Sama289/ALU_and_Custumized_Counter/Phase_2.PDF

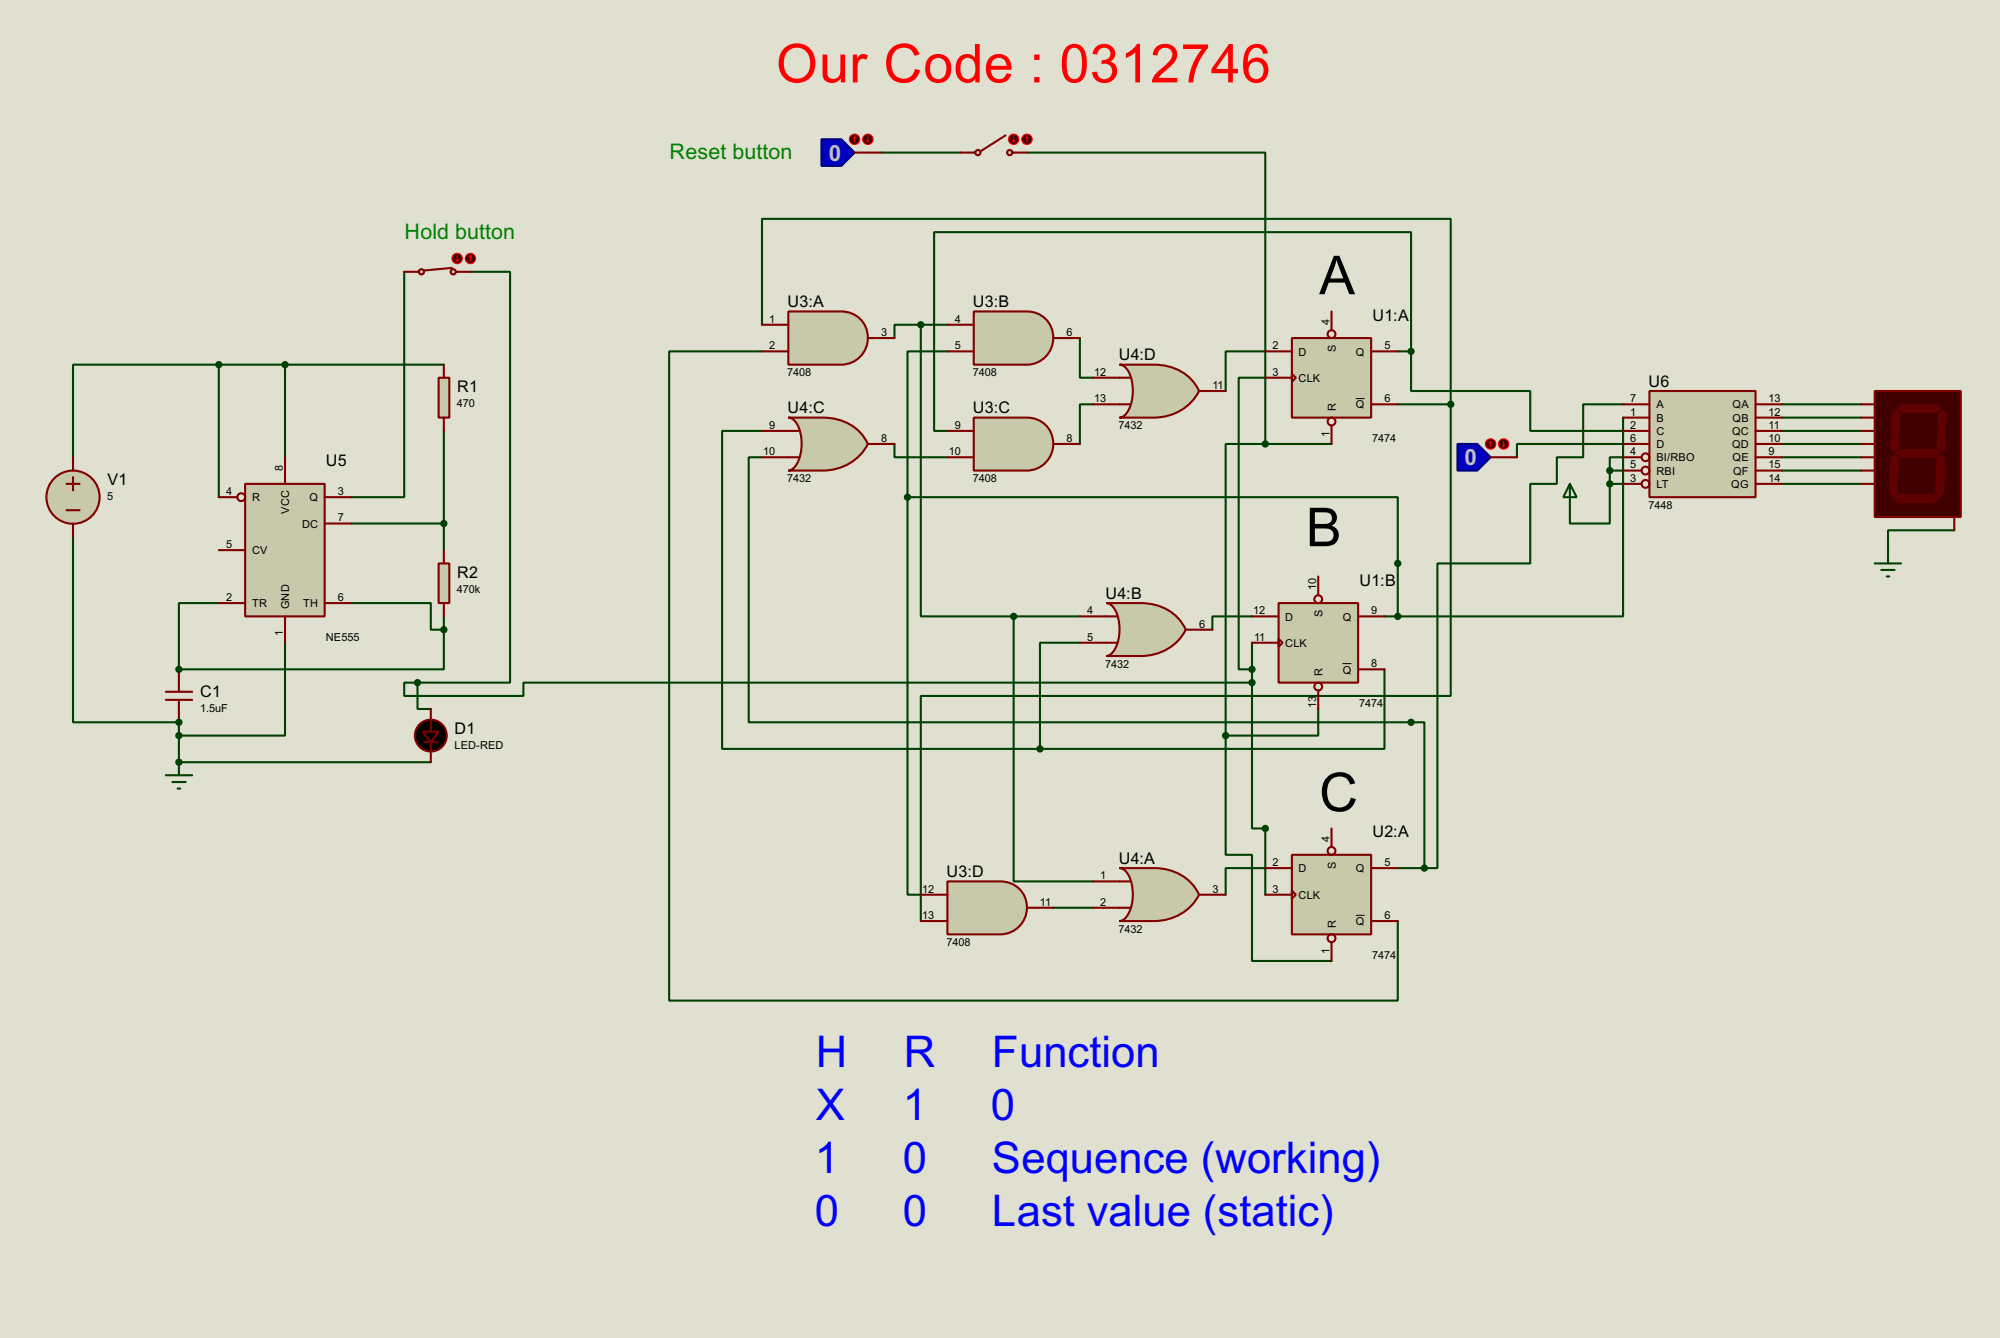
[picture p40: page 1]
