Sama289/ALU_and_Custumized_Counter/Phase 1 Simulation Final version.PDF

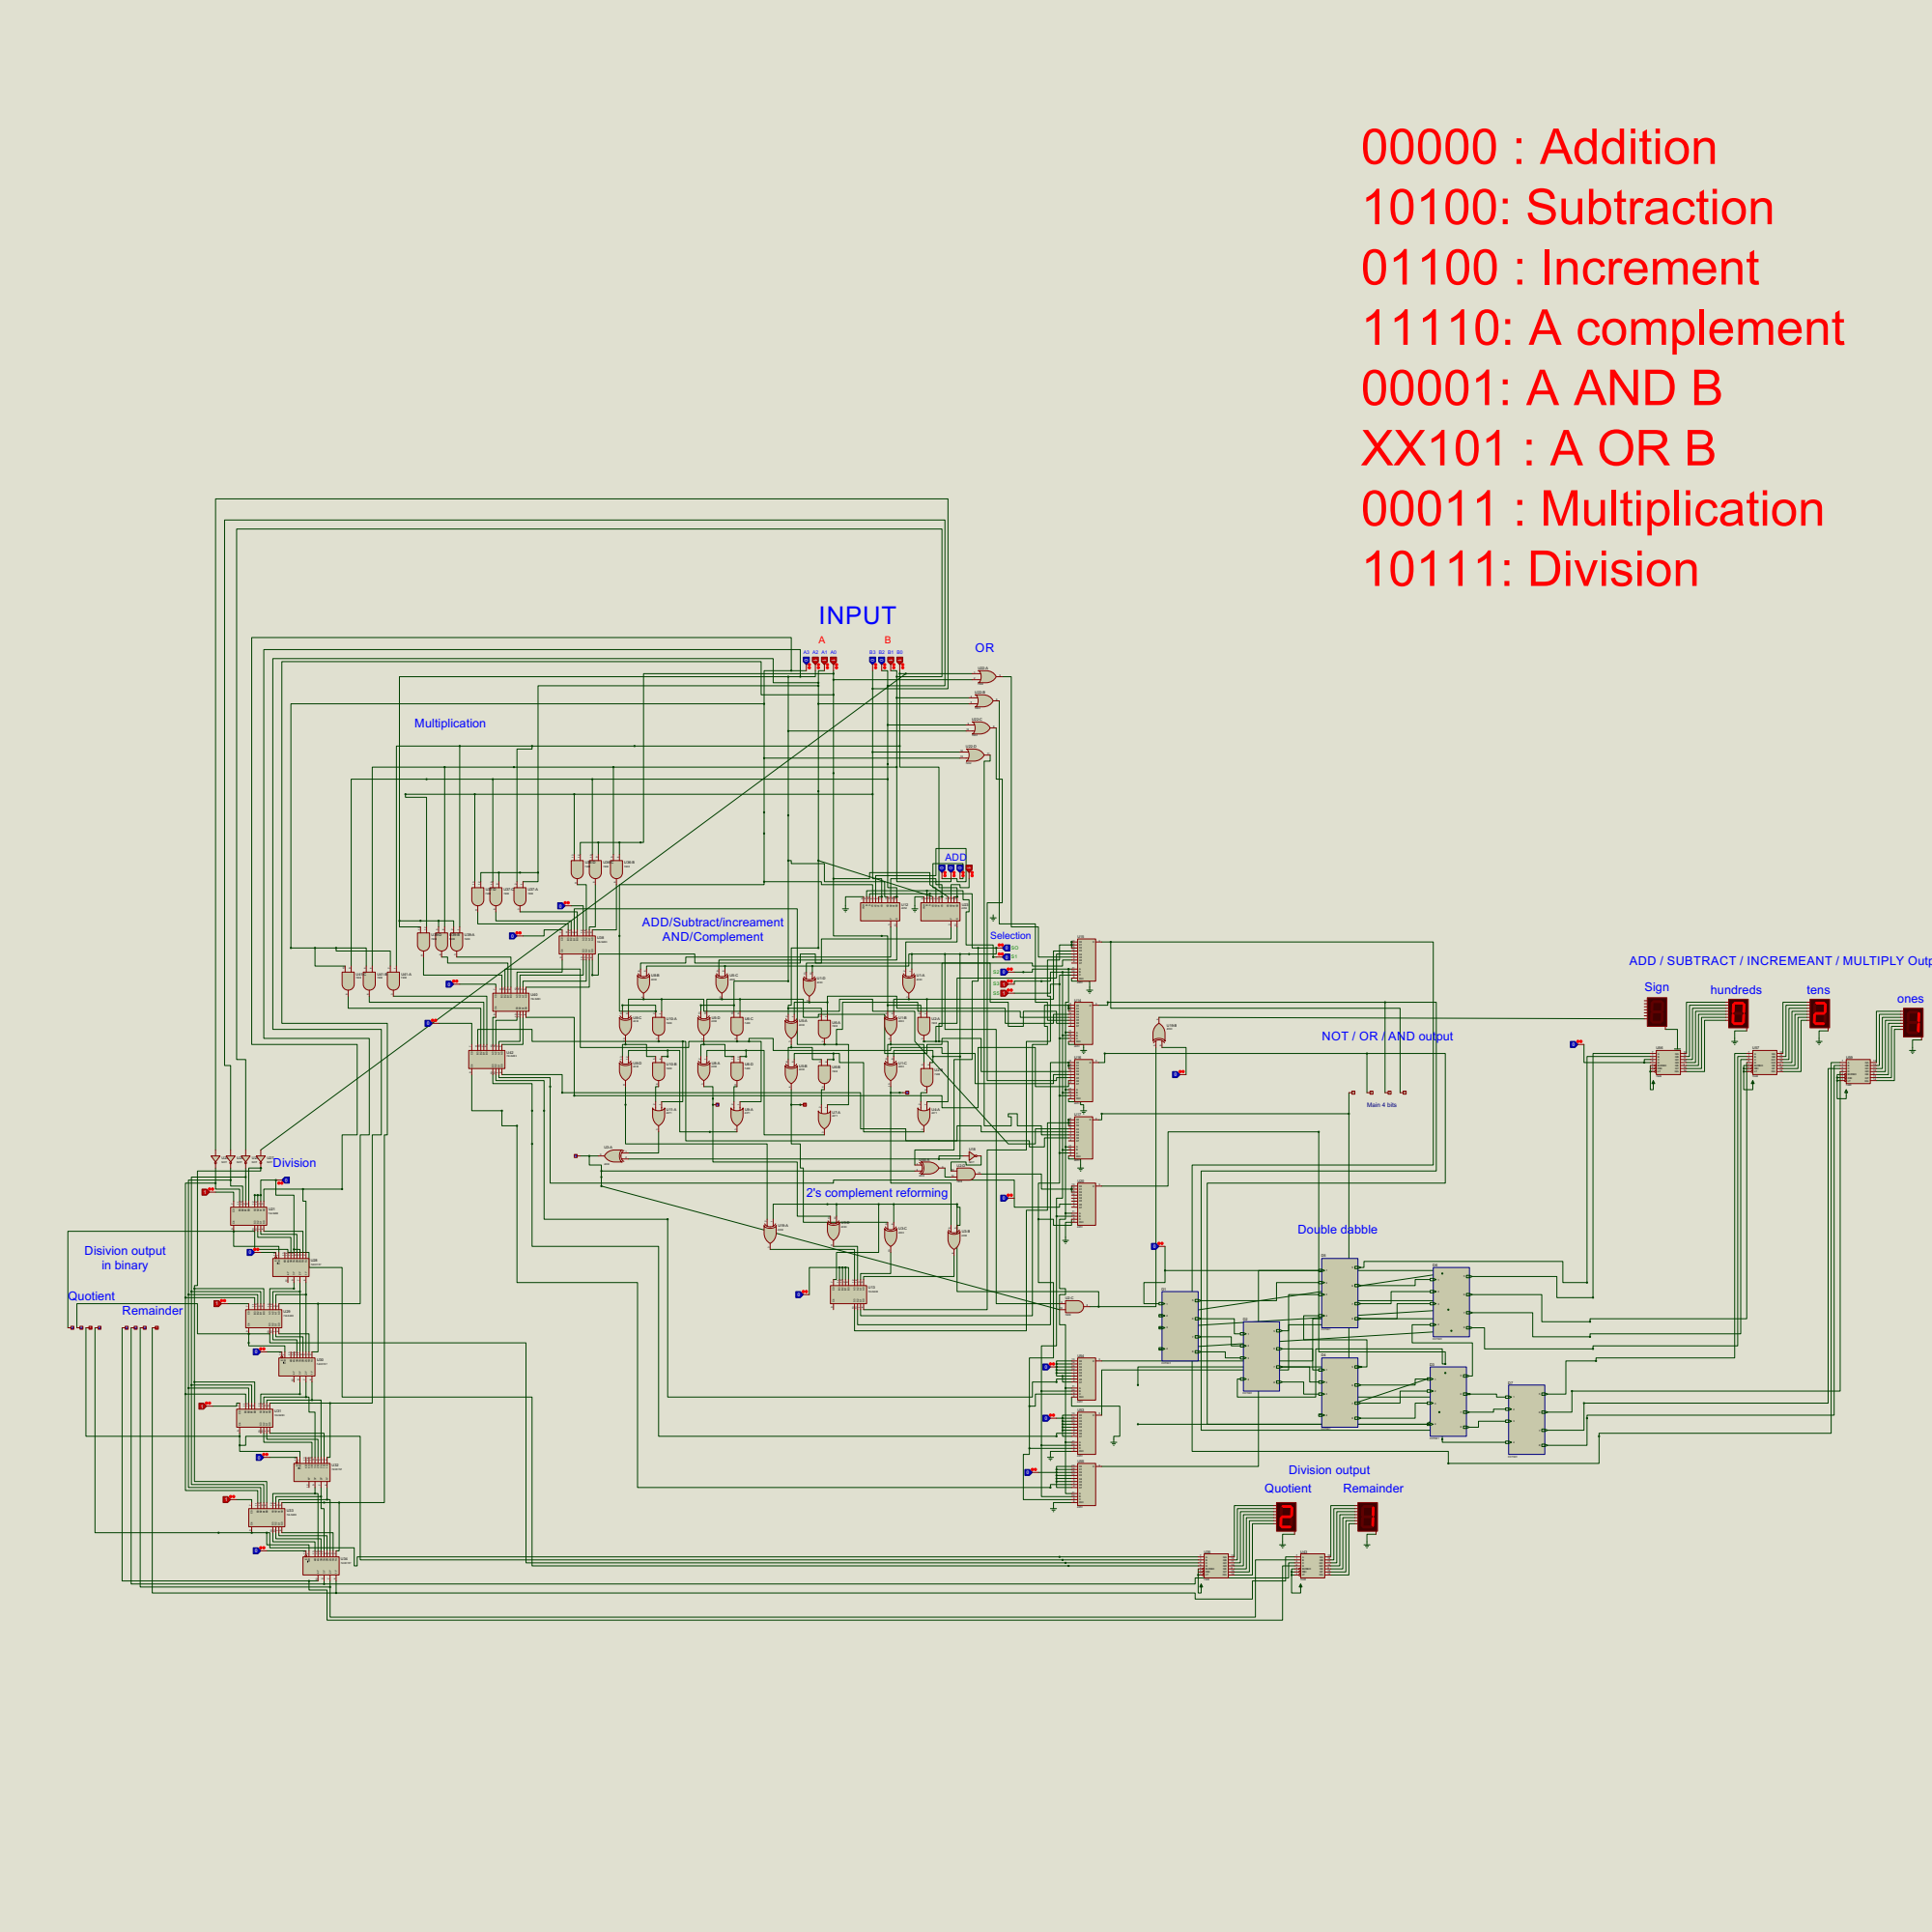
[picture p41: page 1]

ADD / SUBTRACT / INCREMEANT / MULTIPLY Output

1 | INH

NOT / OR / AND output

Disivion output in binary Quotient

Remainder
