Sama289/ALU_and_Custumized_Counter/(list of files, drawings)

Other design files:
Phase 1 Simulation Final version.pdsprj
Phase_2 Simulation Final Version.pdsprj
