Sama289/ALU_and_Custumized_Counter/(commit log)

2023-08-21 Phase 1 simulation
    [Phase 1 Simulation Final version.pdsprj]
2023-08-21 Phase 2 Simulation
    [Phase_2 Simulation Final Version.pdsprj]
